del874/fightBoard/ultra-slim-rev2/CNC-case/top.step

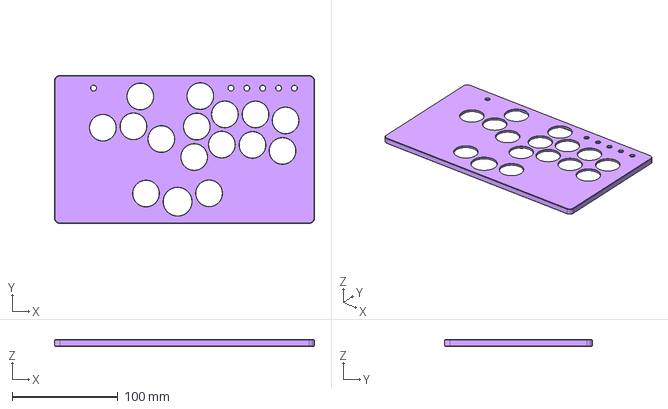
[picture p9: CAD file, 2025-12-03]
ultra-slim-rev2/CNC-case/top.step
246.0 x 140.0 x 6.30 mm
