del874/fightBoard/ultra-slim-rev2/small_parts/cap_26.stl

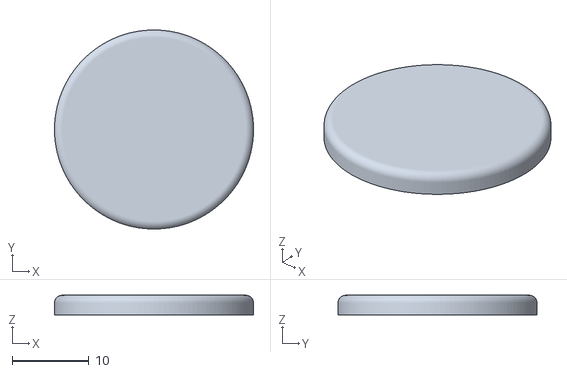
[picture p10: CAD file, 2025-12-03]
ultra-slim-rev2/small_parts/cap_26.stl
26.0 x 26.0 x 2.56
