del874/fightBoard/ultra-slim-rev2/CNC-case/bottom.step

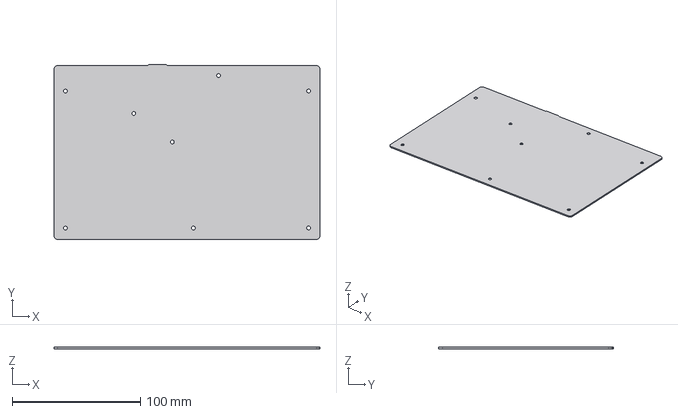
[picture p11: CAD file, 2025-12-03]
ultra-slim-rev2/CNC-case/bottom.step
207.8 x 136.6 x 1.20 mm
