del874/fightBoard/ultra-slim-rev2/small_parts/cap_24.stl

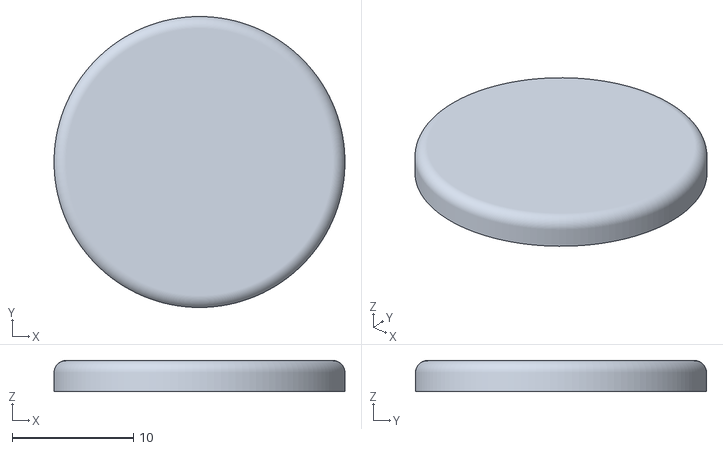
[picture p12: CAD file, 2025-12-03]
ultra-slim-rev2/small_parts/cap_24.stl
24.0 x 24.0 x 2.56
