del874/fightBoard/ultra-slim-rev2/CNC-case/anti-slip-rubber.dxf

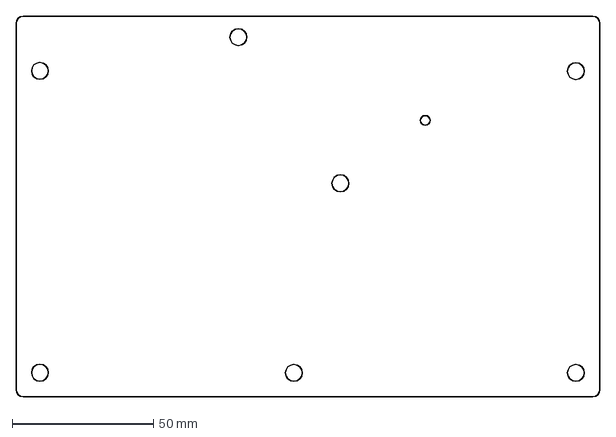
[picture p13: CAD file, 2025-12-03]
ultra-slim-rev2/CNC-case/anti-slip-rubber.dxf
206.8 x 134.8 mm
