del874/fightBoard/ultra-slim-rev2/pcb/ultra-slim-rev2-schematics.pdf

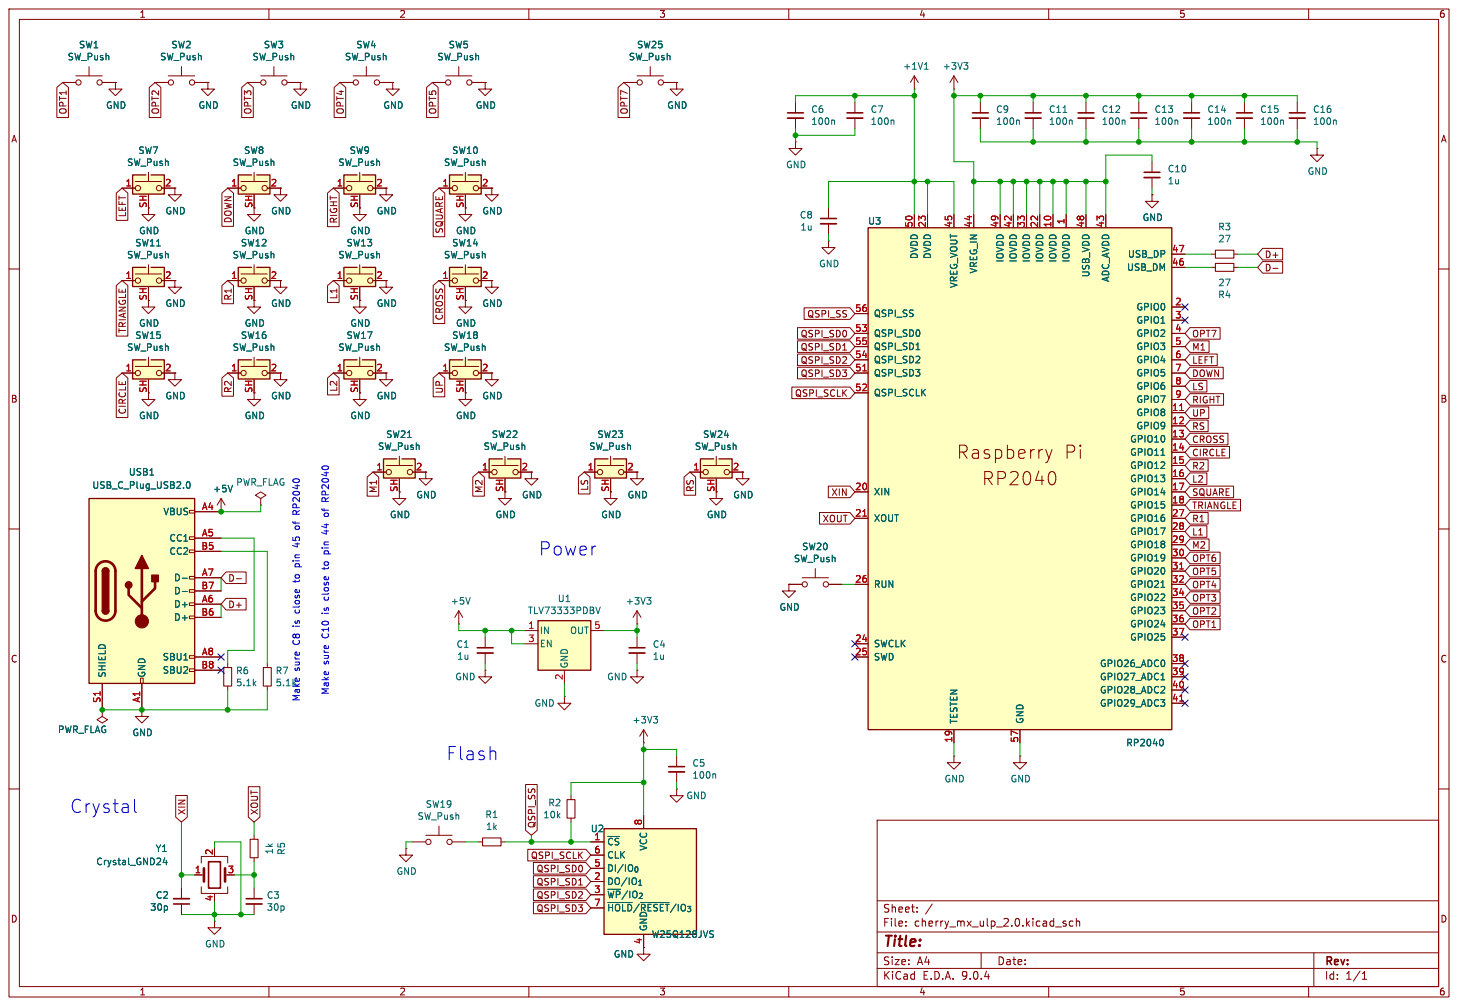
[picture p14: page 1]

2 OUT 5 U1 TLV73333PDBV GND GND GND Raspberry Pi

L1OPT1 OPT4 M2 OPT3 OPT6 OPT2 OPT5 CIRCLE CROSS RIGHT UPRS

Flash Make sure C10 is close to pin 44 of RP2040

Id: 1/1 Title: File: cherry_mx_ulp_2.0.kicad_sch Sheet: / GND
